GKD-RM-Lab/SuperCap_GKD/Docs/ucc27201_func_diagram.png

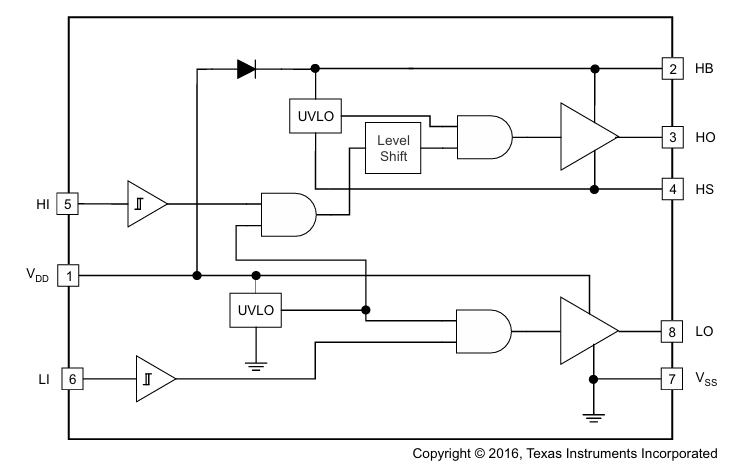
Docs/ucc27201_func_diagram.png
