GKD-RM-Lab/SuperCap_GKD/Docs/ucc27201_structure.png

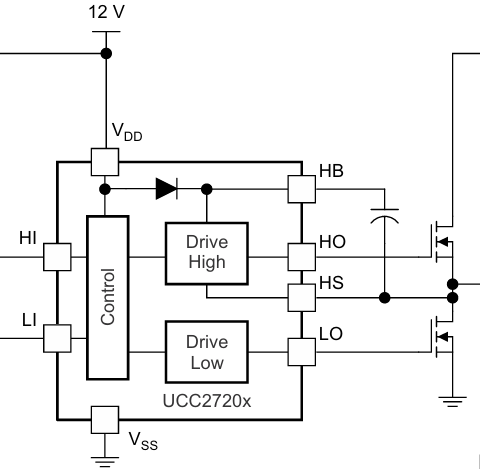
Docs/ucc27201_structure.png
