GKD-RM-Lab/SuperCap_GKD/Calibration/cal.xlsx

 | real data |  | adcxx.sum |  | adc value |  | k | b
VASide | 12 | 24 |  |  | 1483 | 2969 | 0.008075370121 | 0.02422611036
VBSide | 12 | 28.8 |  |  | 1477 | 3552 | 0.008096385542 | 0.04163855422
IAConvert | 1 | 8 |  |  | 1995.4 | 1648.7 | -0.02019036631 | 41.28785694
Ireferee | 1 | 8 |  |  | 1994.3 | 1647.9 | -0.02020785219 | 41.30051963
IBConvert | 1 | 8 |  |  | 1994.6 | 1648.4 | -0.02021952629 | 41.32986713
ID=101
VASide | 14 | 24 | 13690 | 23480 | 1711.25 | 2935 | 0.008171603677 | 0.01634320735
VBSide | 14 | 24 | 13790 | 23670 | 1723.75 | 2958.75 | 0.008097165992 | 0.04251012146
 |  |  |  |  | 0 | 0 | #DIV/0! | #DIV/0!
IAConvert | 1.004 | 3.002 | 16776 | 17560 | 2097 | 2195 | 0.0203877551 | -41.74912245
Ireferee | 1 | 3 | 16765 | 17545 | 2095.625 | 2193.125 | 0.02051282051 | -41.98717949
IBConvert | 1 | 3 | 15970 | 15180 | 1996.25 | 1897.5 | -0.02025316456 | 41.43037975
ID=102
VASide | 13 | 24 | 12745 | 23580 | 1593.125 | 2947.5 | 0.008121827411 | 0.06091370558
VBSide | 13 | 24 | 12660 | 23415 | 1582.5 | 2926.875 | 0.008182240818 | 0.05160390516
 |  |  |  |  | 0 | 0 | #DIV/0! | #DIV/0!
IAConvert | 1.001 | 5.009 | 16768 | 18345 | 2096 | 2293.125 | 0.02033227647 | -41.61545149
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
