GKD-RM-Lab/SuperCap_GKD/hardware/SuperCap2024_Control_V1.1R_F3_ISOPWR/SuperCap2024Control_V1.1R_F3_ISOPWR.kicad_pcb

## KiCad design hardware/SuperCap2024_Control_V1.1R_F3_ISOPWR/SuperCap2024Control_V1.1R_F3_ISOPWR.kicad_pcb (2025-02-18)

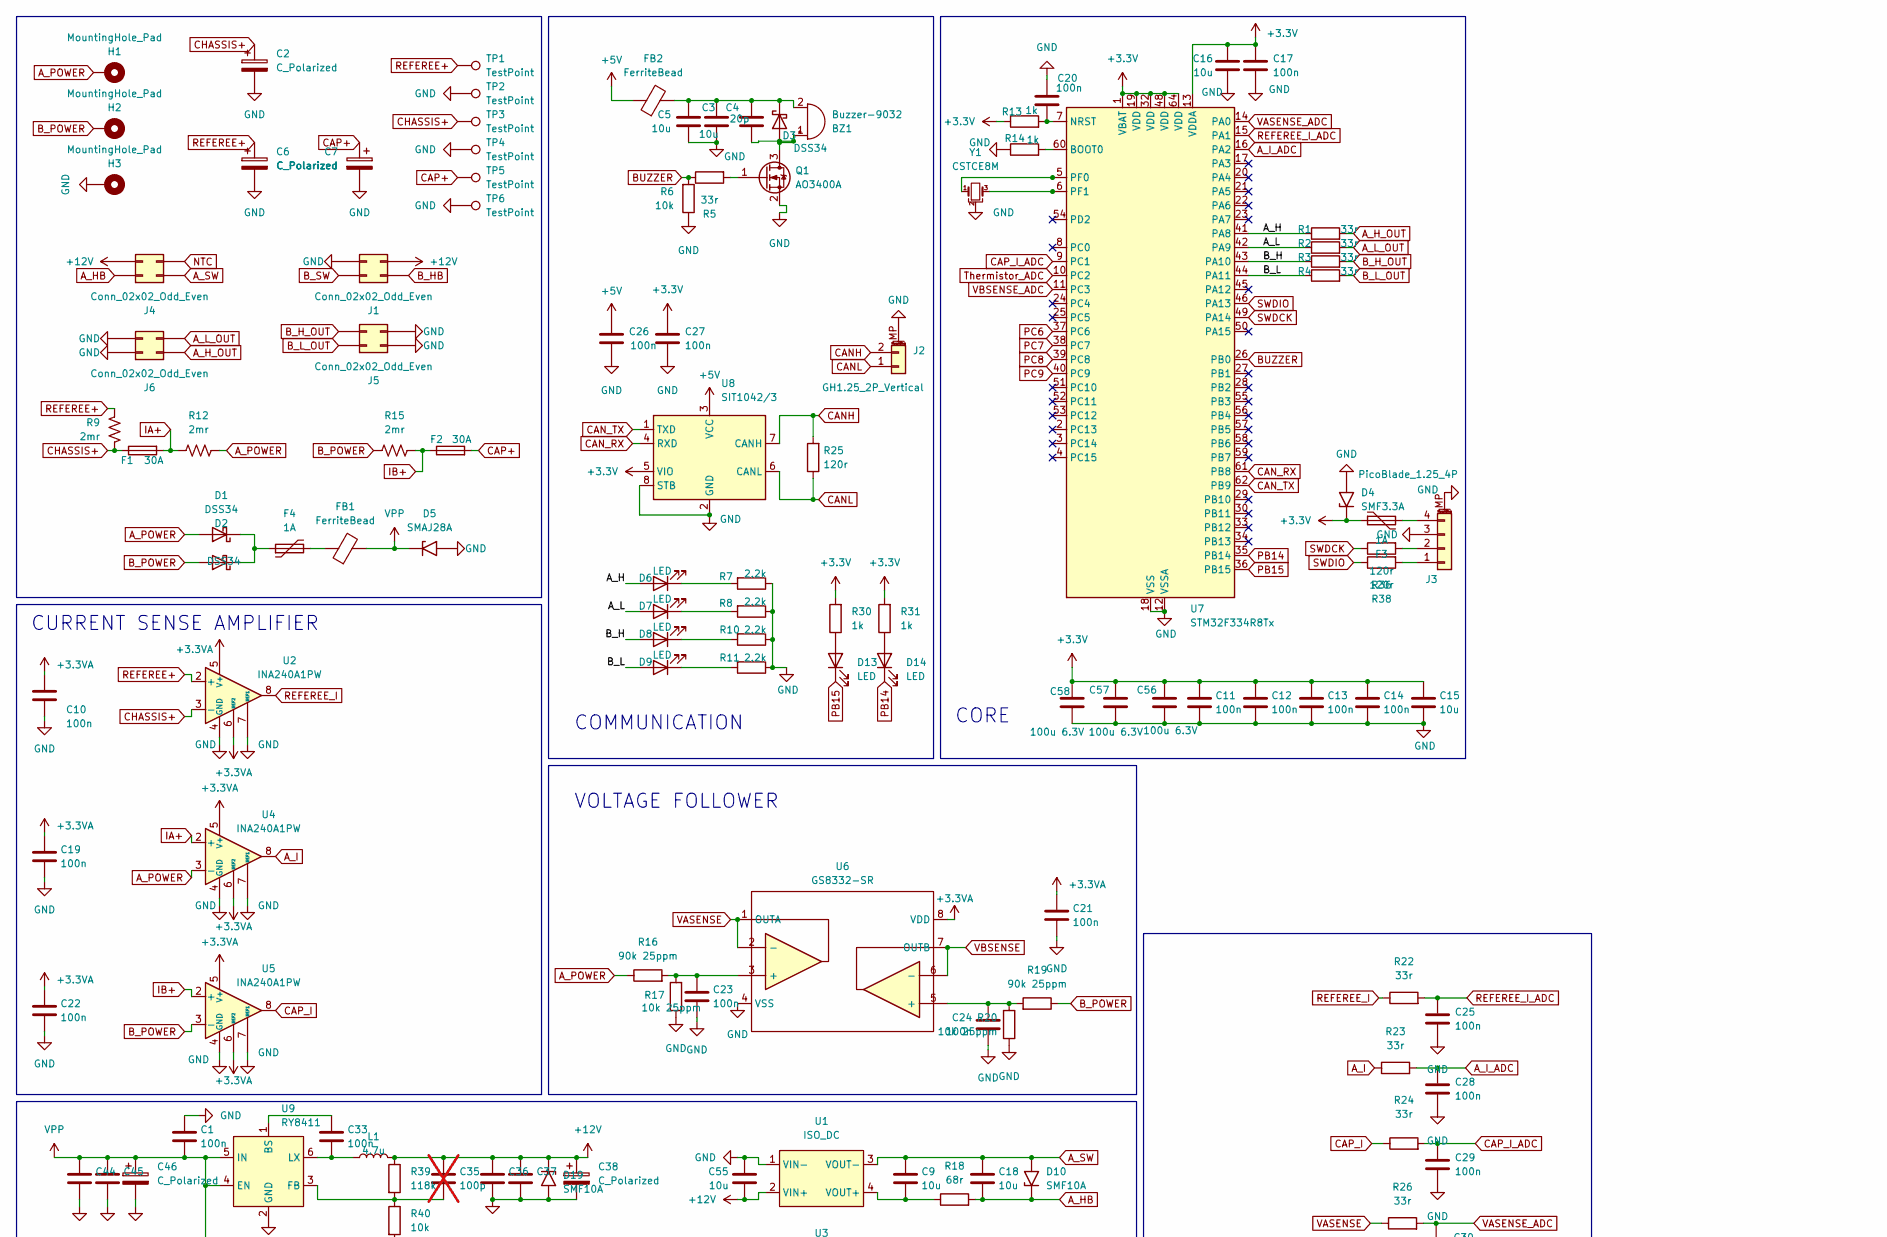
[picture p13: schematic SuperCap2024Control_V1.1R_F3_ISOPWR.kicad_sch, part in row 1, column 1]

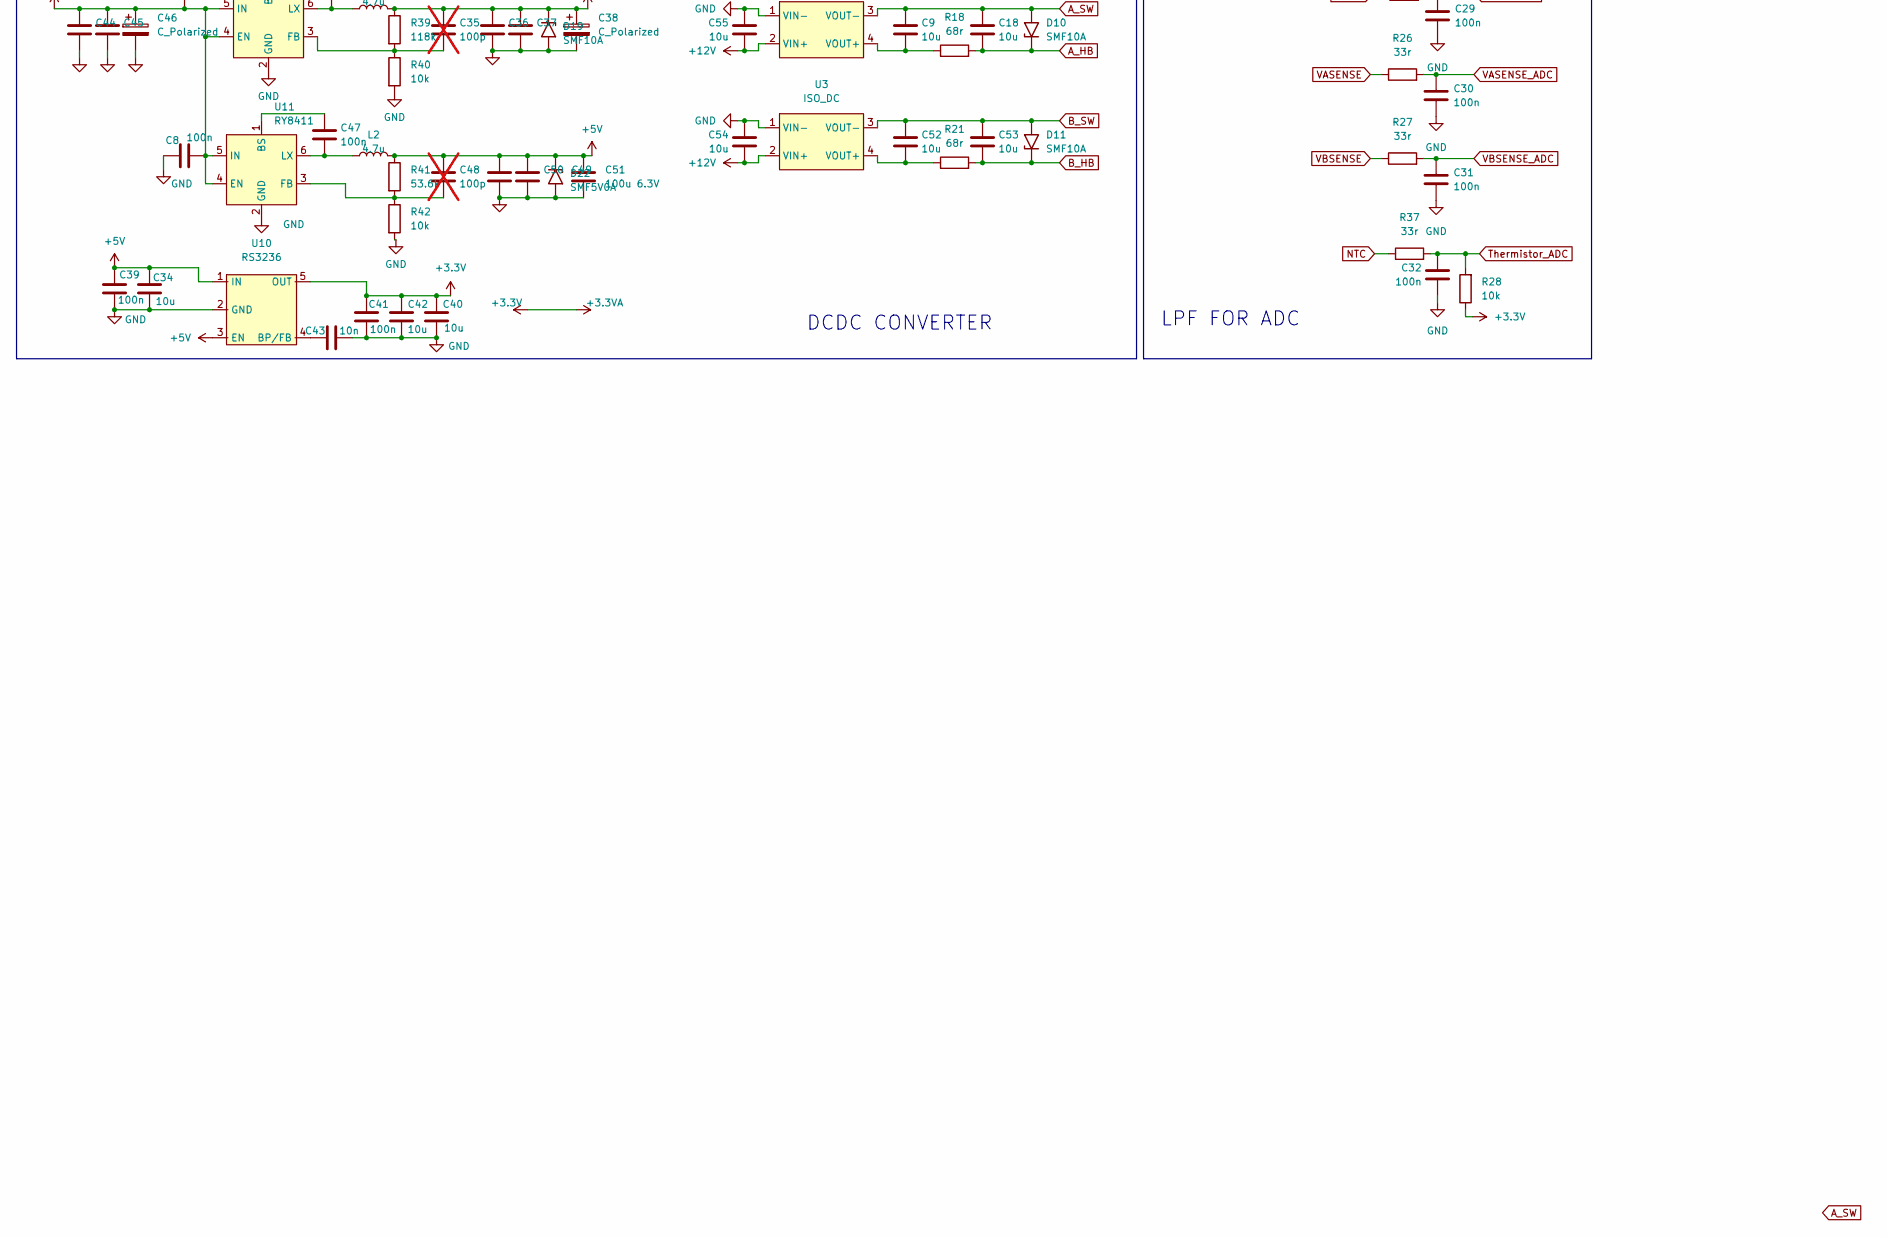
[picture p14: schematic SuperCap2024Control_V1.1R_F3_ISOPWR.kicad_sch, part in row 2, column 1]

Parts:
BZ1: Buzzer-9032; MLT-9032
C1, C8, C10, C11, C12, C13, C14, C17, C19, C20, C21, C22, C23, C24, C25, C26, C27, C28, C29, C30, C31, C32, C33, C39, C41, C47: 100n; C_0603_1608Metric
C2, C6, C7: C_Polarized; CP_Radial_D8.0mm_P3.50mm
C3, C5, C15, C16, C34, C40, C42: 10u; C_0603_1608Metric
C4: 20p; C_0603_1608Metric
C9, C18, C36, C37, C44, C45, C49, C50, C52, C53, C54, C55: 10u; C_1206_3216Metric
C35, C48: 100p; C_0603_1608Metric; not fitted
C38, C46: C_Polarized; CP_EIA-6032-28_Kemet-C
C43: 10n; C_0603_1608Metric
C51, C56, C57, C58: 100u 6.3V; C_1206_3216Metric
D1, D2, D3: DSS34; D_SMF
D4: SMF3.3A; D_SMF
D5: SMAJ28A; D_SMA
D6, D7, D8, D9, D13, D14: LED; LED_0603_1608Metric
D10, D11, D19: SMF10A; D_SMF
D22: SMF5V0A; D_SMF
F1, F2: 30A; Fuse_1206_3216Metric
F3, F4: 1A; Fuse_1206_3216Metric
FB1: FerriteBead; L_1206_3216Metric
FB2: FerriteBead; L_0603_1608Metric
H1, H2, H3: MountingHole_Pad; MountingHole_3.2mm_M3_ISO14580_Pad
J1, J4: Conn_02x02_Odd_Even; PinHeader_2x02_P2.54mm_Vertical_SMD
J2: GH1.25_2P_Vertical; JST_GH_SM02B-GHS-TB_1x02-1MP_P1.25mm_Horizontal
J3: PicoBlade_1.25_4P; Molex_PicoBlade_53261-0471_1x04-1MP_P1.25mm_Horizontal
J5, J6: Conn_02x02_Odd_Even; PinHeader_2x02_P2.54mm_Vertical
L1: 4.7u; L_Bourns-SRN4018
L2: 4.7u; L_Sunlord_SWPA252012S
Q1: AO3400A; SOT-23
R1, R2, R3, R4, R5, R22, R23, R24, R26, R27, R37: 33r; R_0603_1608Metric
R6, R28, R40, R42: 10k; R_0603_1608Metric
R7, R8, R10, R11: 2.2k; R_0603_1608Metric
R9, R12, R15: 2mr; R_2512_6332Metric
R13, R14, R30, R31: 1k; R_0603_1608Metric
R16, R19: 90k 25ppm; R_0603_1608Metric
R17, R20: 10k 25ppm; R_0603_1608Metric
R18, R21: 68r; R_0603_1608Metric
R25, R36, R38: 120r; R_0603_1608Metric
R39: 118k; R_0603_1608Metric
R41: 53.6k; R_0603_1608Metric
TP1, TP2, TP3, TP4, TP5, TP6: TestPoint; TestPoint_Plated_Hole_D3.0mm
U1, U3: ISO_DC; BxxxxS-1W
U2, U4, U5: INA240A1PW; TSSOP-8_4.4x3mm_P0.65mm
U6: GS8332-SR; SOIC-8_3.9x4.9mm_P1.27mm
U7: STM32F334R8Tx; LQFP-64_10x10mm_P0.5mm
U8: SIT1042/3; SOIC-8_3.9x4.9mm_P1.27mm
U9, U11: RY8411; SOT-23-6
U10: RS3236; SOT-23-5
Y1: CSTCE8M; Resonator_SMD_Murata_CSTxExxV-3Pin_3.0x1.1mm

Connections:
+3.3V: C10.1, C11.1, C12.1, C13.1, C14.1, C15.1, C16.2, C17.2, C19.1, C21.1, C22.1, C27.2, C40.1, C41.1, C42.1, C56.1, C57.1, C58.1, D4.1 (A1), F3.1, R13.1, R28.1, R30.2, R31.2, U2.5 (V+), U2.6 (REF2), U4.5 (V+), U4.6 (REF2), U5.5 (V+), U5.6 (REF2), U6.8 (VDD), U7.1 (VBAT), U7.13 (VDDA), U7.19 (VDD), U7.32 (VDD), U7.48 (VDD), U7.64 (VDD), U8.5 (VIO), U10.5 (OUT)
+5V: C26.2, C34.1, C39.1, C48.1, C49.1, C50.1, C51.1, D22.1 (A1), FB2.1, L2.2, R41.1, U8.3 (VCC), U10.1 (IN), U10.3 (EN)
+12V: C35.1, C36.1, C37.1, C38.1, C54.2, C55.2, D19.1 (A1), J1.4, J4.3, L1.2, R39.1, U1.2 (VIN+), U3.2 (VIN+)
/A_H: D6.2 (A), R1.1, U7.41 (PA8)
/A_L: D7.2 (A), R2.1, U7.42 (PA9)
/B_H: D8.2 (A), R3.1, U7.43 (PA10)
/B_L: D9.2 (A), R4.1, U7.44 (PA11)
A_HB: C18.2, D10.1 (A1), J4.1, R18.2
A_H_OUT: J6.2, R1.2
A_I: R23.1, U4.8
A_I_ADC: C28.2, R23.2, U7.16 (PA2)
A_L_OUT: J6.4, R2.2
A_POWER: D1.2 (A), H1.1, R12.2, R16.1, U4.3 (-)
A_SW: C9.1, C18.1, D10.2 (A2), J4.2, U1.3 (VOUT-)
BUZZER: R5.1, R6.2, U7.26 (PB0)
B_HB: C53.2, D11.1 (A1), J1.2, R21.2
B_H_OUT: J5.3, R3.2
B_L_OUT: J5.1, R4.2
B_POWER: D2.2 (A), H2.1, R15.1, R19.1, U5.3 (-)
B_SW: C52.1, C53.1, D11.2 (A2), J1.1, U3.3 (VOUT-)
CANH: J2.2, R25.2, U8.7 (CANH)
CANL: J2.1, R25.1, U8.6 (CANL)
CAN_RX: U7.61 (PB8), U8.4 (RXD)
CAN_TX: U7.62 (PB9), U8.1 (TXD)
CAP+: C7.1, F2.2, TP5.1
CAP_I: R24.1, U5.8
CAP_I_ADC: C29.2, R24.2, U7.9 (PC1)
CHASSIS+: C2.1, F1.1, R9.2, TP3.1, U2.3 (-)
GND: C1.1, C2.2, C3.1, C5.1, C6.2, C7.2, C8.2, C10.2, C11.2, C12.2, C13.2, C14.2, C15.2, C16.1, C17.1, C19.2, C20.2, C21.2, C22.2, C23.2, C24.2, C25.1, C26.1, C27.1, C28.1, C29.1, C30.1, C31.1, C32.2, C34.2, C36.2, C37.2, C38.2, C39.2, C40.2, C41.2, C42.2, C43.2, C44.2, C45.2, C46.2, C49.2, C50.2, C51.2, C54.1, C55.1, C56.2, C57.2, C58.2, D4.2 (A2), D5.2 (A2), D19.2 (A2), D22.2 (A2), H3.1, J1.3, J2.MP (MountPin), J3.3, J3.MP (MountPin), J5.2, J5.4, J6.1, J6.3, Q1.2 (S), R6.1, R7.1, R8.1, R10.1, R11.1, R14.1, R17.1, R20.1, R40.2, R42.2, TP2.1, TP4.1, TP6.1, U1.1 (VIN-), U2.1 (GND), U2.4 (GND), U2.7 (REF1), U3.1 (VIN-), U4.1 (GND), U4.4 (GND), U4.7 (REF1), U5.1 (GND), U5.4 (GND), U5.7 (REF1), U6.4 (VSS), U7.12 (VSSA), U7.18 (VSS), U7.31 (VSS), U7.47 (VSS), U7.63 (VSS), U8.2 (GND), U8.8 (STB), U9.2 (GND), U10.2 (GND), U11.2 (GND), Y1.2
IA+: F1.2, R12.1, U4.2 (+)
IB+: F2.1, R15.2, U5.2 (+)
NTC: J4.4, R37.1
unnamed: BZ1.2 (+), C3.2, C4.2, C5.2, D3.1 (K), FB2.2
unnamed: BZ1.1 (-), C4.1, D3.2 (A), Q1.3 (D)
unnamed: C23.1, R16.2, R17.2, U6.3 (+)
unnamed: C24.1, R19.2, R20.2, U6.5 (+)
unnamed: D1.1 (K), D2.1 (K), F4.1
unnamed: D6.1 (K), R7.2
unnamed: D7.1 (K), R8.2
unnamed: D8.1 (K), R10.2
unnamed: D9.1 (K), R11.2
unnamed: D13.2 (A), R30.1
unnamed: D14.2 (A), R31.1
unnamed: F4.2, FB1.1
unnamed: J3.1, R38.2
unnamed: J3.2, R36.2
unnamed: F3.2, J3.4
unnamed: Q1.1 (G), R5.2
unnamed: C9.2, R18.1, U1.4 (VOUT+)
unnamed: C52.2, R21.1, U3.4 (VOUT+)
unnamed: R14.2, U7.60 (BOOT0)
unnamed: C20.1, R13.2, U7.7 (NRST)
unnamed: U7.5 (PF0), Y1.1
unnamed: U7.6 (PF1), Y1.3
unnamed: C33.1, U9.1 (BS)
unnamed: C35.2, R39.2, R40.1, U9.3 (FB)
unnamed: C33.2, L1.1, U9.6 (LX)
unnamed: C43.1, U10.4 (BP/FB)
unnamed: C47.1, U11.1 (BS)
unnamed: C48.2, R41.2, R42.1, U11.3 (FB)
unnamed: C47.2, L2.1, U11.6 (LX)
PB14: D14.1 (K), U7.35 (PB14)
PB15: D13.1 (K), U7.36 (PB15)
PC6: U7.37 (PC6)
PC7: U7.38 (PC7)
PC8: U7.39 (PC8)
PC9: U7.40 (PC9)
REFEREE+: C6.1, R9.1, TP1.1, U2.2 (+)
REFEREE_I: R22.1, U2.8
REFEREE_I_ADC: C25.2, R22.2, U7.15 (PA1)
SWDCK: R36.1, U7.49 (PA14)
SWDIO: R38.1, U7.46 (PA13)
Thermistor_ADC: C32.1, R28.2, R37.2, U7.10 (PC2)
VASENSE: R26.1, U6.1 (OUTA), U6.2 (-)
VASENSE_ADC: C30.2, R26.2, U7.14 (PA0)
VBSENSE: R27.1, U6.6 (-), U6.7 (OUTB)
VBSENSE_ADC: C31.2, R27.2, U7.11 (PC3)
VPP: C1.2, C8.1, C44.1, C45.1, C46.1, D5.1 (A1), FB1.2, U9.4 (EN), U9.5 (IN), U11.4 (EN), U11.5 (IN)

Notes on the sheet:
COMMUNICATION
CURRENT SENSE AMPLIFIER
CORE
DCDC CONVERTER
VOLTAGE FOLLOWER
LPF FOR ADC

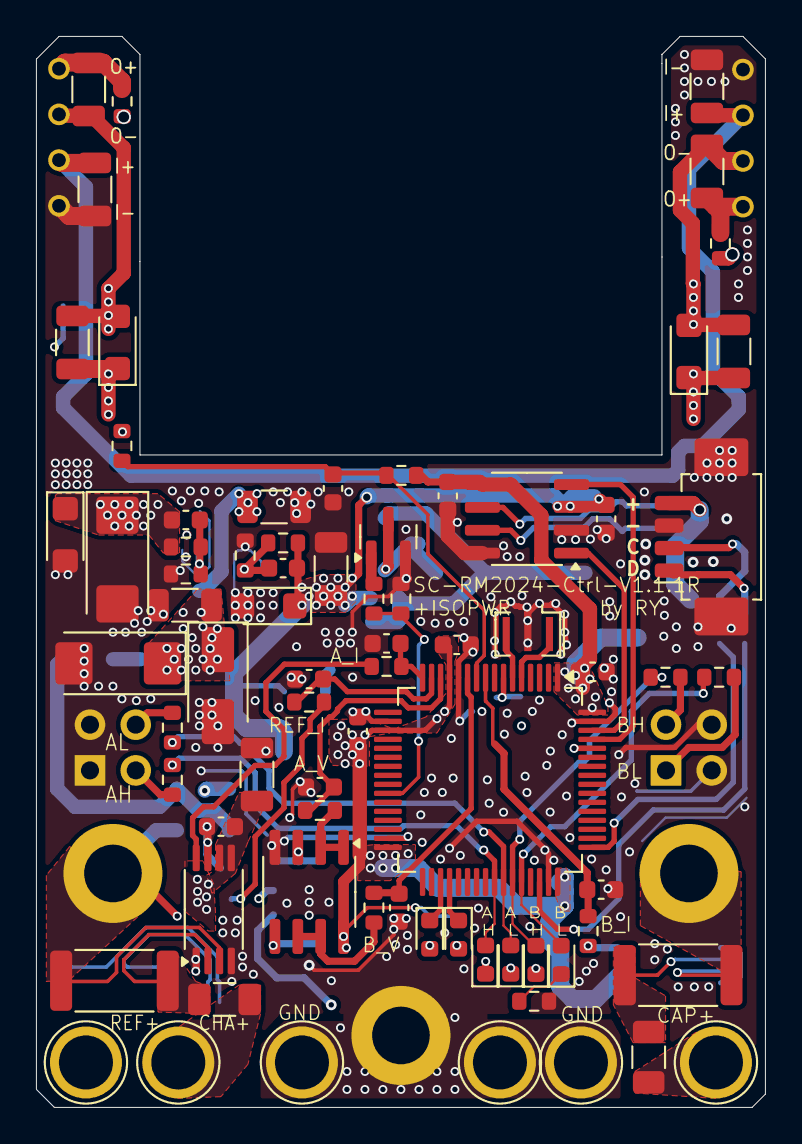
[picture p15: board SuperCap2024Control_V1.1R_F3_ISOPWR.kicad_pcb from above]

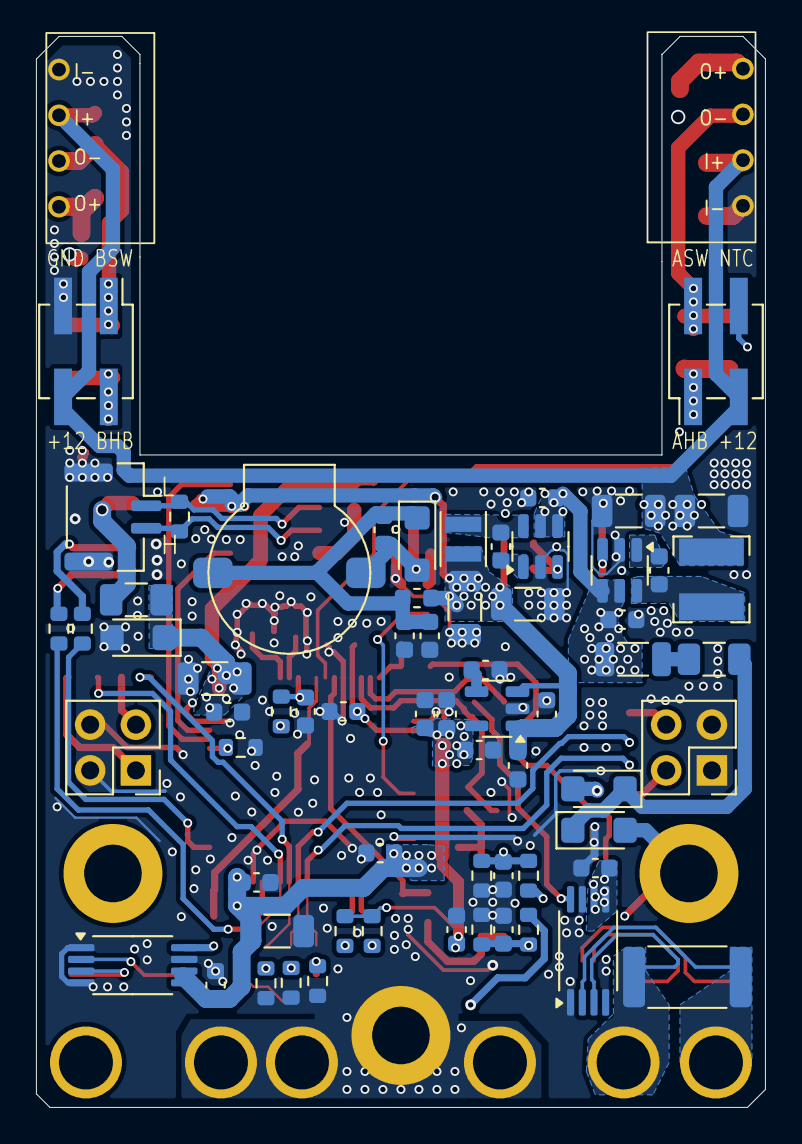
[picture p16: board SuperCap2024Control_V1.1R_F3_ISOPWR.kicad_pcb from below]

Board: 4 copper layers, 40.5 x 59.5 mm, 144 parts (67 on the bottom side), 74 nets.
