GKD-RM-Lab/SuperCap_GKD/hardware/SuperCap2024_Power_V1.2R/SuperCap2024V1.2R_Power.kicad_pcb

## KiCad design hardware/SuperCap2024_Power_V1.2R/SuperCap2024V1.2R_Power.kicad_pcb (2025-02-18)

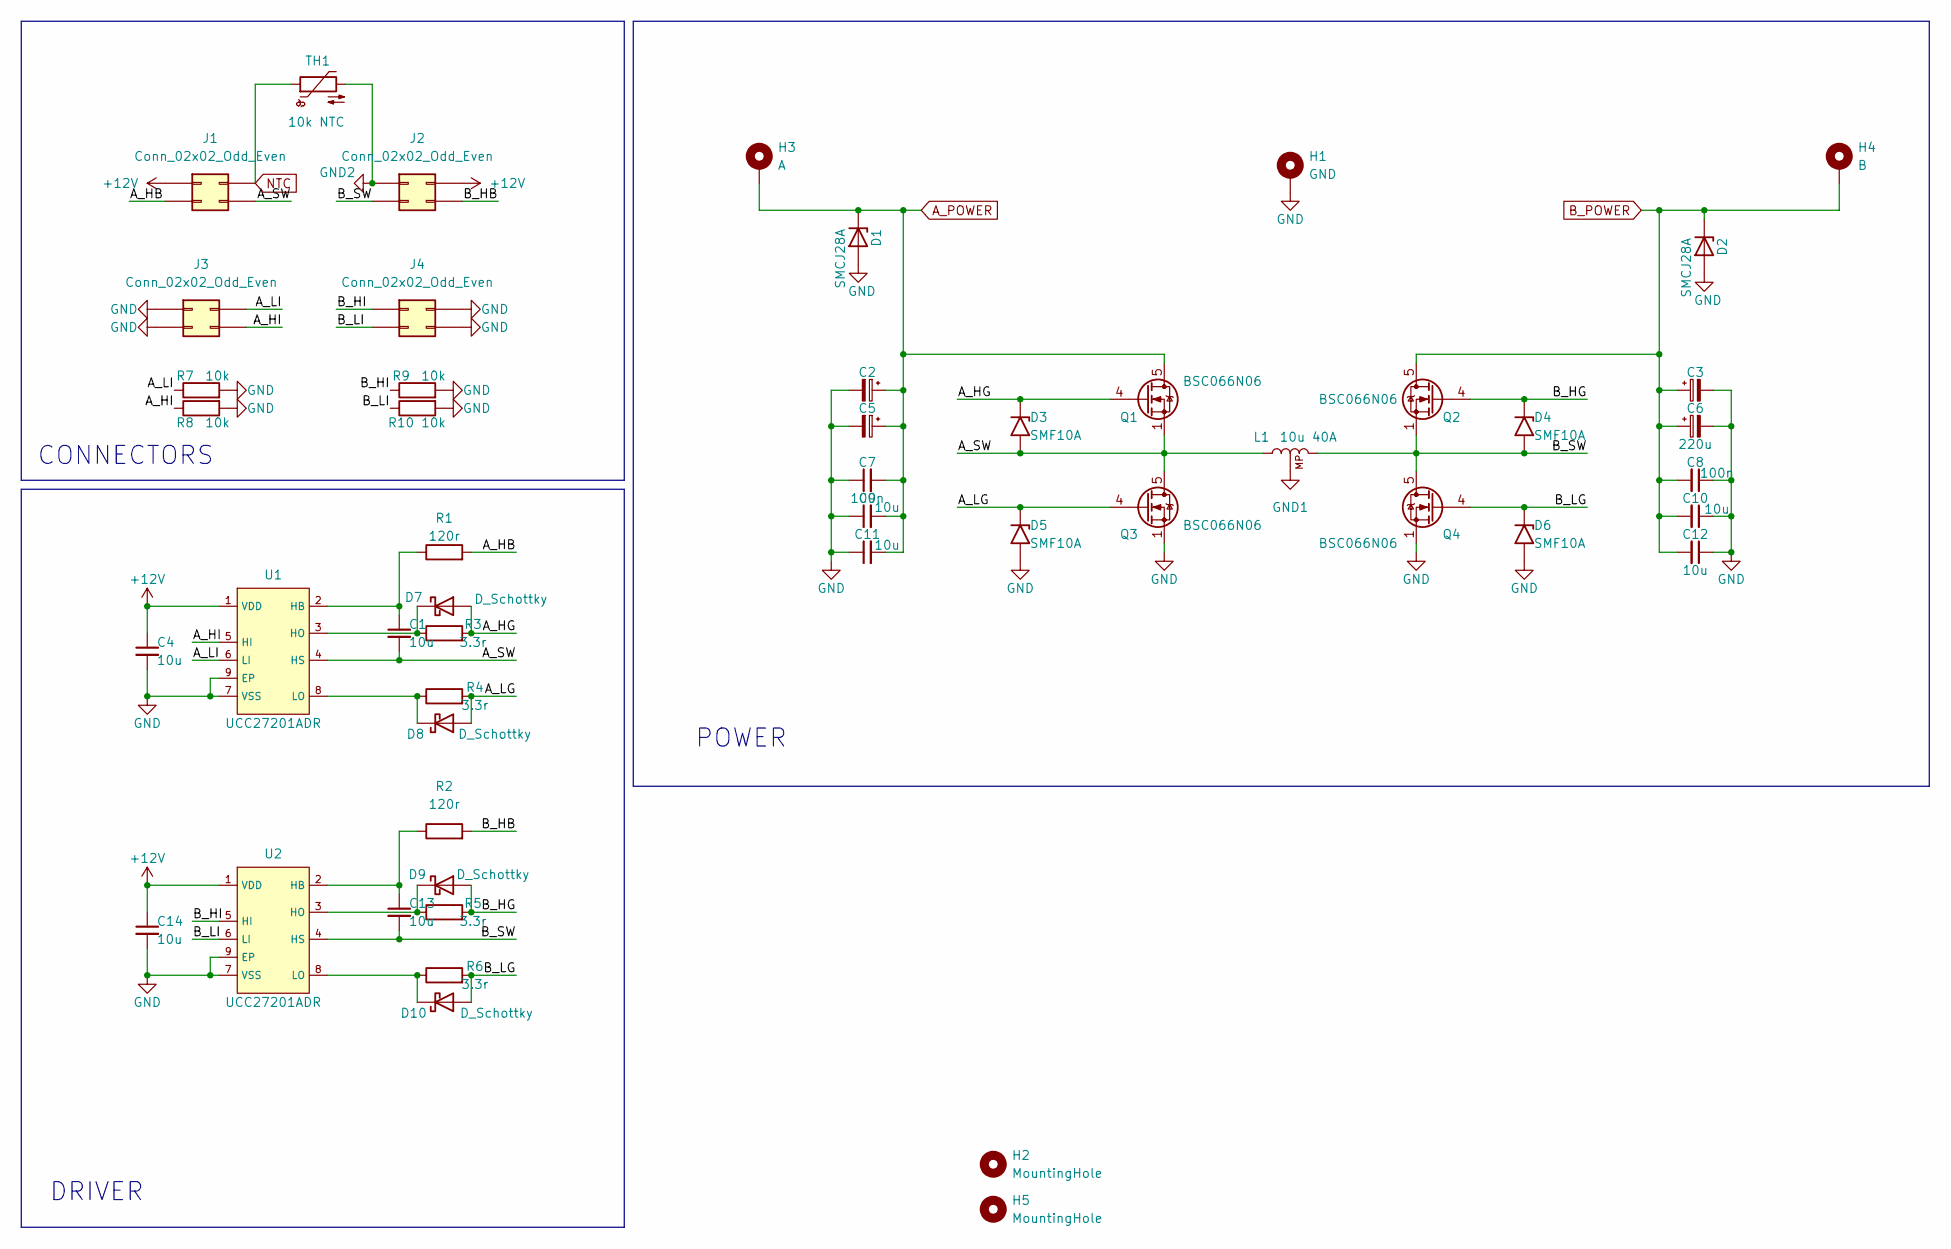
[picture p17: schematic SuperCap2024V1.2R_Power.kicad_sch]

Parts:
C1, C13: 10u; C_0603_1608Metric
C2, C3, C5, C6: 220u; CP_Elec_8x10
C4, C9, C10, C11, C12, C14: 10u; C_1206_3216Metric
C7, C8: 100n; C_0603_1608Metric
D1, D2: SMCJ28A; D_SMC
D3, D4, D5, D6: SMF10A; D_SOD-123F
D7, D8, D9, D10: D_Schottky; D_SOD-123F
H1: GND; TestPoint_Pad_D4.0mm
H2, H5: MountingHole; MountingHole_3.2mm_M3
H3: A; TestPoint_Pad_D4.0mm
H4: B; TestPoint_Pad_D4.0mm
J1, J2, J3, J4: Conn_02x02_Odd_Even; PinHeader_2x02_P2.54mm_Vertical_SMD
L1: 10u 40A; PQ2617BHA
Q1, Q2, Q3, Q4: BSC066N06; TDSON-8-1_HandSolder
R1, R2: 120r; R_1206_3216Metric
R3, R4, R5, R6: 3.3r; R_0603_1608Metric
R7, R8, R9, R10: 10k; R_0603_1608Metric
TH1: 10k NTC; R_1206_3216Metric
U1, U2: UCC27201ADR; SOP-8_3.9x4.9mm_P1.27mm

Connections:
+12V: C4.1, C14.1, J1.1, J2.2, U1.1 (VDD), U2.1 (VDD)
/A_HB: J1.3, R1.2
/A_HG: D3.1 (A1), D7.2 (A), Q1.4 (G), R3.2
/A_HI: J3.4, R8.1, U1.5 (HI)
/A_LG: D5.1 (A1), D8.2 (A), Q3.4 (G), R4.2
/A_LI: J3.2, R7.1, U1.6 (LI)
/A_SW: C1.2, D3.2 (A2), J1.4, L1.1, Q1.1 (S), Q1.2 (S), Q1.3 (S), Q3.5 (D), U1.4 (HS)
/B_HB: J2.4, R2.2
/B_HG: D4.1 (A1), D9.2 (A), Q2.4 (G), R5.2
/B_HI: J4.1, R9.1, U2.5 (HI)
/B_LG: D6.1 (A1), D10.2 (A), Q4.4 (G), R6.2
/B_LI: J4.3, R10.1, U2.6 (LI)
/B_SW: C13.2, D4.2 (A2), J2.3, L1.2, Q2.1 (S), Q2.2 (S), Q2.3 (S), Q4.5 (D), U2.4 (HS)
A_POWER: C2.1, C5.1, C7.2, C9.2, C11.2, D1.1 (K), H3.1, Q1.5 (D)
B_POWER: C3.1, C6.1, C8.2, C10.2, C12.2, D2.1 (K), H4.1, Q2.5 (D)
GND: C2.2, C3.2, C4.2, C5.2, C6.2, C7.1, C8.1, C9.1, C10.1, C11.1, C12.1, C14.2, D1.2 (A), D2.2 (A), D5.2 (A2), D6.2 (A2), H1.1, J3.1, J3.3, J4.2, J4.4, Q3.1 (S), Q3.2 (S), Q3.3 (S), Q4.1 (S), Q4.2 (S), Q4.3 (S), R7.2, R8.2, R9.2, R10.2, U1.7 (VSS), U1.9 (EP), U2.7 (VSS), U2.9 (EP)
GND1: L1.3 (MP)
GND2: J2.1, TH1.2
NTC: J1.2, TH1.1
unnamed: C1.1, R1.1, U1.2 (HB)
unnamed: D7.1 (K), R3.1, U1.3 (HO)
unnamed: D8.1 (K), R4.1, U1.8 (LO)
unnamed: C13.1, R2.1, U2.2 (HB)
unnamed: D9.1 (K), R5.1, U2.3 (HO)
unnamed: D10.1 (K), R6.1, U2.8 (LO)

Notes on the sheet:
POWER
DRIVER
CONNECTORS

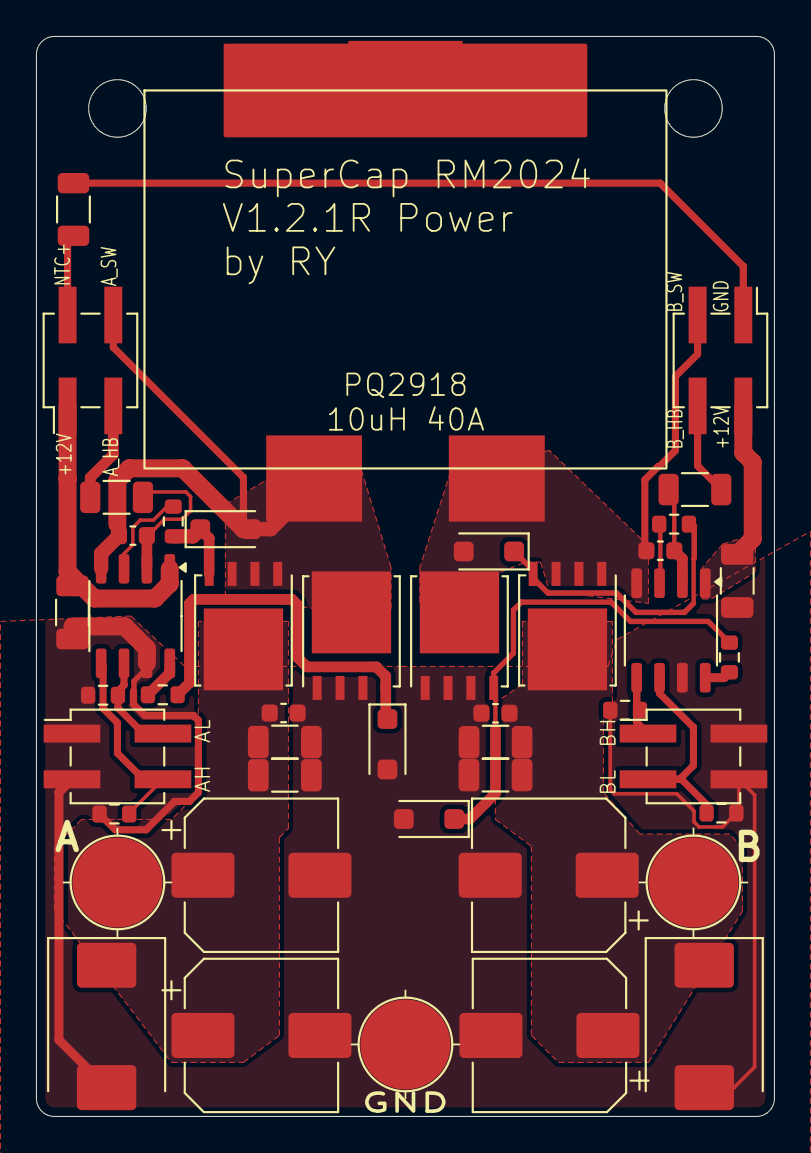
[picture p18: board SuperCap2024V1.2R_Power.kicad_pcb from above]

Board: 2 copper layers, 41.0 x 60.0 mm, 47 parts (0 on the bottom side), 24 nets.
