GKD-RM-Lab/SuperCap_GKD/RM2024-SuperCap-F3-V0.2.ioc

Mcu.UserName=STM32F334R8Tx
PA0.GPIO_Label=V_SENSE_A
PA0.Signal=ADC1_IN1
PA1.GPIO_Label=I_SENSE_JUDGE
PA1.Signal=ADC1_IN2
PA10.GPIO_Label=MOS_B_H
PA10.Signal=HRTIM1_CHB1
PA11.GPIO_Label=MOS_B_L
PA11.Signal=HRTIM1_CHB2
PA13.Signal=SYS_JTMS-SWDIO
PA14.Signal=SYS_JTCK-SWCLK
PA2.GPIO_Label=I_SENSE_A
PA2.Signal=ADC1_IN3
PA8.GPIO_Label=MOS_A_H
PA8.Signal=HRTIM1_CHA1
PA9.GPIO_Label=MOS_A_L
PA9.Signal=HRTIM1_CHA2
PB0.GPIO_Label=TIM1_CH2N_BUZZER
PB0.Signal=TIM1_CH2N
PB14.Signal=GPIO_Output
PB15.Signal=GPIO_Output
PB3.Signal=USART2_TX
PB4.Signal=USART2_RX
PB8.Signal=CAN_RX
PB9.Signal=CAN_TX
PC1.GPIO_Label=I_SENSE_CAP
PC1.Signal=ADCx_IN7
PC2.GPIO_Label=SENSE_THERMAL
PC2.Signal=ADCx_IN8
PC3.GPIO_Label=V_SENSE_B
PC3.Signal=ADCx_IN9
