GKD-RM-Lab/SuperCap_GKD/(commit log)

2025-02-22 Calibration Done,ID=101
    [cal.xlsx]
2025-03-10 Calibration Done,ID=102
    [cal.xlsx]
2025-03-11 modify README
    [cal.xlsx]
2025-03-18 cali+modify README
    [cal.xlsx]
